hb9xcg/energex/supervisor/doc/supervisor.jpeg

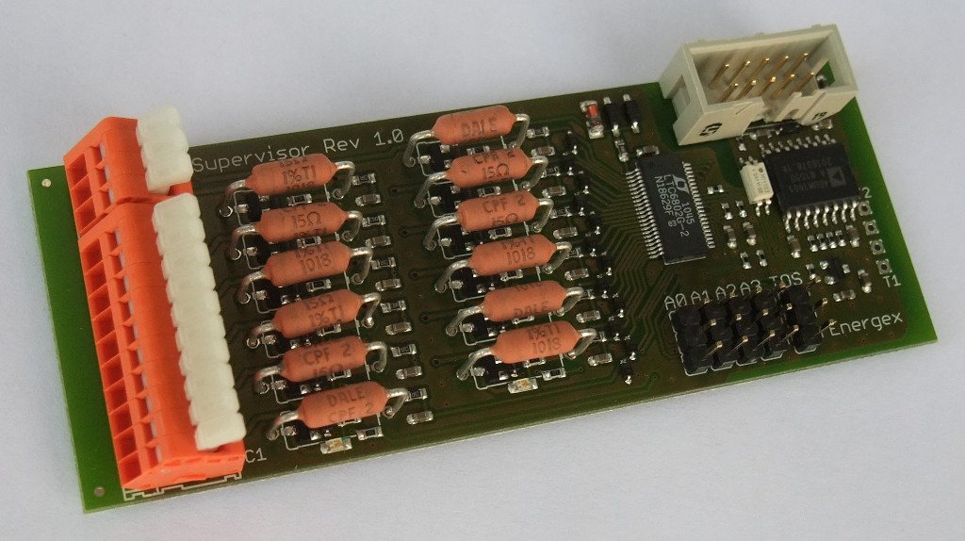
supervisor/doc/supervisor.jpeg
