hb9xcg/energex/QTwikeAnalyzer/README

QTwikeAnalyzer version 0.4

Thanx for downloading QTwikeAnalyzer

These are the features so far:
 * Recording and playback of the Twike RS485 traffic.
 * On the fly decoding of the protocol.
 * Creating voltage, current and temperature plots for each battery.
 * Downloading new firmware to mediator battery controller.

Please report bugs and tell me what you like/dislike
about the application!

Have a lot of fun
Markus Walser (markus.walser@gmail.com)
