hb9xcg/energex/mediator/doc/laden.odt

- Entladen
  - 287: BINFO ist 00 00
  - 287: D-State ist 6: Warten auf Netzspannung
  - 292: Relais-State (0x12) ist 11 (Relais Closed?)
  - 5071: FINFO ist 00 20
  - 5123: Sobald Batterie Spannung < 310V ist, wird BINFO 00 40: (zu tiefe Fahrspannung)
  - 24139: Sobald alle Batterien < 290V, wird entladen gestoppt.
- Warten auf Ladespannung
  - 24204: FINFO ist 00 20
- Vorladen
  - 24270: Wird mit D-State Broadcast zweimal angekündigt: (d-State = Vorladen)
  - 24497: FINFO ist 00 20
  - 24743: Relais State closed (0x11)
  - 24791: FINFO ist 00 20
  - 25084: FINFO ist 00 20
  - 25001: BINFO wechselt von 00 40 zu 00 00, da Batterie Spannung wieder > 310V
  - Ladestrom steigt mit zunehmender Batteriespannung auf 0.22A / Block (0.66A total)
- Vorlade Relais schliessen
  - 29992: Wir mit D-State Broadcast zweimal angekündigt: (d-State = 8)
  - 30001: BINFO ist 00 00
  - 30004: Relais-State Command 0x12 -> Relais schliessen (0x11)
  - 30015: BINFO ist 00 00
- I-Ladung
  - 30018: Wird mit D-State Broadcast zweimal angekündigt (d-State = 9)
  - 30475: BINFO ist 00 00
  - Ladestrom steigt auf total 4.5A
  - 31414: FINFO ist 00 20
  - 69726: Broadcast Relais State Command (0x12) -> Close (0x01), es sind 410V erreicht.
  - Ladestrom wird reduziert, Spannung fällt.
  - 69789: BINFO ist 00 00
  - 69869: Relais State ist closed (0x01)
  - 77581: FINFO ist 00 20
  - 78290: D-State ist immer noch 9 (I-Ladung)
- U-Ladung
  - 79673: Wird beim erreichen von 435V mit zwei Broadcasts angekündigt (d-State = 0xA)
  - 79685: BINFO ist 00 00
  - 80097: Relais State ist noch closed (0x01)
  - 81441: FINFO ist 00 20
  - 88114: BINFO ist 09 05 (Charge Temp To Low, Batt Full, Drive NOK, Rekup NOK) Gemäss Checksumme ist BINFO aber eher 01 03 (Batt Full, Rekup NOK, Charge NOK)
- Batterie Relais öffnen
  - 88115: Wird mit D-State Broadcast zweimal angekündigt (d-State = 0xB) während Batteriestrom noch ~1A / Block ist.
  - 88122: BINFO von Batterie 3 ist 0x01 0x01: (BatFull, Rekup NOK)
  - Strom wird auf 0A reduziert.
  - 88167: Message an Batterie 3: Open Relais
  - 88171: BINFO von Batterie 3 wird 0x01 0x81 (Bat Full, BatRelaisOpen, Rekup NOK)
- Nachladung
  - 88220: Wird mit zwei Broadcasts angekündigt (d-State = 0x0C)
  - 88231: Batterie 2 Relais State Closed (0x01)
  - 88233: Batterie 3 Relais State Open (0x00)
  - 88279: FINFO Bat 2 (und Bat 1) 00 20
  - 88281: FINFO Bat 3 00 64 (zusätzlich wurden Bit 2 und Bit 6 gesetzt)
  - Ladestrom wird erhöht.
  - 90271: Batterie 2 meldet BINFO 0x01 0x01
- Batterie Relais öffnen
  - 90274: .Wird mit D-State Broadcast zweimal angekündigt (d-State 0x0b) während Ladestrom noch je ~0.5A bei Block 1 und Block 2 ist.
  - Ladestrom wird auf 0A reduziert.
  - 90326: Message an Batterie 2: Open Relais
  - 90328: BINFO von Bat 2 ist neu 0x01 0x81 (BatFull, BatRelOpen, Rekup NOK)
- Nachladung
  - 90377: Wird mit zwei Broadcast angekündigt (d-State =0xC)
  - 90636: FINFO von Bat 2 ist neu wie von Bat 3 auch 0x00 0x64
  - 91390: Batterie 1 meldet BINFO 0x01 0x01 (BatFull, Rekup NOK)
- Batterie Relais öffnen
  - 91393: Wird mit D-State Broadcast zweimal angekündigt (d-State = 0xB) während Ladestrom von Batterie 1 noch 0.5A ist.
  - Ladestrom wird auf 0A reduziert.
  - 91440: BINFO sind Bat1 0x01 0x01, Bat2 0x01 0x81 und Bat3 0x01 0x81
- Batterie Relais schliessen
  - 91445: Wird mit zwei Broadcast angekündigt (d-State =0x0D)
  - 91520: FINFO von Bat1 0x00 0x24
  - 91522: FINFO von Bat2 0x00 0x64
  - 94567: Broadcast an alle Batterien das Relais (0x12) zu schliessen (0x01)
  - Alle Batterien melden BINFO 0x01 0x01
- Symetrierladung
  - 94577: Wird mit zwei Broadcasts angekündigt (d-State = 0x0E)
  - 94768: FINFO von Bat1 0x0024
  - 94760: FINFO von Bat2 0x0064
  - 94772: FINFO von Bat3 0x0064
  - Ladestrom wird erhöht.
  - 96352: Bei Bat3 steigt der Strom auf 0.29A, worauf diese BINFO 0x0109 meldet (BatFull, RekupNOK, ChargeCurrToHigh)
  - Der Ladestrom wird auf 0.28A reduziert
  - 96394: Bei Bat3 steigt der Strom auf 0.29A, worauf diese BINFO 0x0109 meldet (BatFull, RekupNOK, ChargeCurrToHigh)
  - Der Ladestrom wird auf 0.28A reduziert
  - 96522: FINFO von Bat1 0x0024
  - 96524: FINFO von Bat2 0x0064
  - 96526: FINFO von Bat3 0x0064
- Pause
  - 107329: Wird mit zwei Broadcasts angekündigt (d-State = 0x10) während Symmetrierstrom von noch je ~0.28A ist.
  - Symmetrierstrom wird auf 0A reduziert.
  - 107343: Broadcast an alle Batterien das Relais (0x12) zu öffnen (0x00)
  - Alle Batterien melden BINFO 0x0181
  - 107404: FINFO von Bat1 0x0024
  - 107406: FINFO von Bat2 0x0064
  - 107408: FINFO von Bat3 0x0064
