hb9xcg/energex/mediator/doc/boot-sequence.odt

Request Type, Checksum ok, Checksum bad, Current, Voltage, Values

10 31 42 27 65 Bat1: Ah Zähler?

10 31 48 80 ff fd 87 d8 36 a3 Bat1: 347.76V -0.02A 5.4Ah

10 32 42 27 65 ff fe 88 53 28 3a 349V

10 32 42 27 65 Bat2: Ah Zähler?

10 32 48 80 ff ff 88 57 28 3f Bat2: 349.03V 0.00A 4.0Ah

10 ff 24 11 01 34 Twike: ? Alle Relais öffnen?

10 ff 24 11 01 34 Twike: ? Alle Relais öffnen?

10 34 42 27 65 Bat3: Ah Zähler?

10 34 48 80 ff fd 88 3f 3b 46 Bat3: 348.79V -0.02A 5.9Ah

10 31 42 61 23 Bat1: Maximale Batterie Temperatur?

10 31 48 80 ff ff 87 db 04 b8 28 Bat1: 347.79V 0.00A 12.08°C

10 ff 24 11 03 36

10 ff 24 11 03 36

10 32 42 61 23 Bat2: Maximale Batterie Temperatur?

10 32 48 80 ff ff 88 5a 04 b8 a6 Bat2: 349.06V 0.00A 12.08°C

10 ff 24 11 30 Alle Relais öffnen! ???

10 ff 24 11 30 Alle Relais öffnen! ???

10 34 42 61 23 Bat3: Maximale Batterie Temperatur?

10 34 48 80 ff fd 88 44 04 ff fd Bat3: 348.84V -0.02A 12.79°C

10 31 42 74 36 Bat1: Entladene Ah?

10 31 48 80 ff ff 87 e1 03 f7 5a Bat1: 347.85V 0.00A 1015Ah

10 32 42 74 36 Bat2: Entladene Ah?

10 32 48 80 ff ff 88 5e 04 21 3b Bat2: 349.10V 0.00A 1057Ah

10 34 42 74 36 Bat3: Entladene Ah?

10 34 48 80 ff fd 88 4d 03 eb e7 Bat3: 349.10V -0.02A 1003Ah

10 31 42 02 40 Bat1: Program Revision?

10 31 48 80 ff ff 87 e0 02 12 bf Bat1: 347.84V 0.00A v5.30

10 32 42 02 40 Bat2: Program Revision?

10 32 48 80 ff ff 88 61 02 12 31 Bat2: 349.13V 0.00A v5.30

10 34 42 02 40 Bat3: Program Revision?

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

10 34 42 47

10 34 48 ff fe 88 56 04 dc 4f

10 31 42 27 65

10 31 48 88 06 36 f0

10 32 42 27 65

10 32 48 88 70 28 98

10 34 42 27 65

10 34 48 ff fe 88 60 3b 9a

10 31 42 31 73

10 31 48 88 1e d5

10 32 42 31 73

10 32 48 88 77 bc

10 34 42 31 73

10 34 48 ff fe 88 5e 2b b4
