hb9xcg/energex/mediator/doc/twike-ebnf.odt

Transfer

Transfer --> Unacked oder Acked

Unacked --> Message

Message --> Header und Command und Checksum

Acked --> Request und Response

Header --> Start und Address und Type

Request --> Header und Parameter und Checksum

Start --> 0x10

Address --> Batterie1 oder Batterie2 oder Batterie3 oder Broadcast

Batterie1 --> 0x31

Batterie2 --> 0x32

Batterie3 --> 0x34

Broadcast --> 0xff

Type --> RequestType oder ResponseType oder MessageType

RequestType --> 0x42

ResponseType --> 0x48

MessageType --> 0x24

Response --> Header und Data und Checksum

Data --> QCounter oder MaxBatT oder ProgRev oder dState oder LadeI oder FahrI oder

SollLadeU oder Leistung oder BatT oder FINFO oder SymU oder TeilU oder Temp oder

UmgT oder MaxQ oder EntQ oder SymI

Qcounter --> Strom und Spannung und Kapazität

MaxBatT --> Strom und Spannung und

ProgRev --> Strom und Spannung und Revision

LadeI -->

FahrI -->

10 32 42 27 65 10 32 48 80 ff ff 88 57 28 3f
