hb9xcg/energex/supervisor/eagle/partlist.pdf

Tabelle1_2

Part | | | Linear | SMD
C1 | 100n / 100V | C0603 | 81-GCM188R72A104KA4D | x
C2 | 100n / 100V | C0603 | 81-GCM188R72A104KA4D | x
C3 | 100n / 100V | C0603 | 81-GCM188R72A104KA4D | x
C4 | 100n / 100V | C0603 | 81-GCM188R72A104KA4D | x
C5 | 100n / 100V | C0603 | 81-GCM188R72A104KA4D | x
C6 | 100n / 100V | C0603 | 81-GCM188R72A104KA4D | x
C7 | 100n / 100V | C0603 | 81-GCM188R72A104KA4D | x
C8 | 100n / 100V | C0603 | 81-GCM188R72A104KA4D | x
C9 | 100n / 100V | C0603 | 81-GCM188R72A104KA4D | x
C10 | 100n / 100V | C0603 | 81-GCM188R72A104KA4D | x
C11 | 100n / 100V | C0603 | 81-GCM188R72A104KA4D | x
C12 | 100n / 100V | C0603 | 81-GCM188R72A104KA4D | x
C13 | 100n / 100V | C0603 | 81-GCM188R72A104KA4D | x
C14 | 1u / 16V | C0603 | 810-C1608Y5V1E105Z | x
C15 | 1u / 16V | C0603 | 810-C1608Y5V1E105Z | x
C16 | 1u / 16V | C0603 | 810-C1608Y5V1E105Z | x
C17 | 1u / 16V | C0603 | 810-C1608Y5V1E105Z | x
C18 | 100n | C0603 | 81-GCM188R72A104KA4D | x
C19 | 100n | C0603 | 81-GCM188R72A104KA4D | x
C20 | 100n | C0603 | 81-GCM188R72A104KA4D | x
C21 | 100n | C0603 | 81-GCM188R72A104KA4D | x
C22 | 1u / 16V | C0603 | 810-C1608Y5V1E105Z | x
CON1 | SPI | CON10 | 617- 09- 18- 510- 7324
D1 | MM3Z12VT1G | SOD323-R | 863-MM3Z12VT1G | x
D2 | PDZ6.2B | SOD323-R | 771-PDZ6.2BT/R | x
D3 | MM3Z12VT1G | SOD323-R | 863-MM3Z12VT1G | x
D4 | PDZ6.2B | SOD323-R | 771-PDZ6.2BT/R | x
D5 | MM3Z12VT1G | SOD323-R | 863-MM3Z12VT1G | x
D6 | PDZ6.2B | SOD323-R | 771-PDZ6.2BT/R | x
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
R51 | 20 | R0603 | 652-CR0603JW-200ELF | x
R52 | 100k | R0402 | P100KDETR-ND | x
R53 | 100k | R0402 | P100KDETR-ND | x
R54 | 100k | R0402 | P100KDETR-ND | x
R55 | 100k | R0402 | P100KDETR-ND | x
R57 | 1M | R0402 | 652-CR0402-JW-105GLF | x
R58 | 1M | R0402 | 652-CR0402-JW-105GLF | x
R59 | 1M | R0402 | 652-CR0402-JW-105GLF | x
R60 | 100k | R0402 | P100KDETR-ND | x
R61 | 100k | R0402 | P100KDETR-ND | x
T1 | BSS308PE | SOT23 | 726- BSS308PEL6327 | x
T1A | WIREPAD1,6/0,8 | 1,6/0,8
T1B | WIREPAD1,6/0,8 | 1,6/0,8
T2 | BSS308PE | SOT23 | 726- BSS308PEL6327 | x
T2A | WIREPAD1,6/0,8 | 1,6/0,8
T2B | WIREPAD1,6/0,8 | 1,6/0,8
T3 | BSS308PE | SOT23 | 726- BSS308PEL6327 | x
T4 | BSS308PE | SOT23 | 726- BSS308PEL6327 | x
T5 | BSS308PE | SOT23 | 726- BSS308PEL6327 | x
T6 | BSS308PE | SOT23 | 726- BSS308PEL6327 | x
T7 | BSS308PE | SOT23 | 726- BSS308PEL6327 | x
T8 | BSS308PE | SOT23 | 726- BSS308PEL6327 | x
T9 | BSS308PE | SOT23 | 726- BSS308PEL6327 | x
T10 | BSS308PE | SOT23 | 726- BSS308PEL6327 | x
T11 | BSS308PE | SOT23 | 726- BSS308PEL6327 | x
T12 | BSS308PE | SOT23 | 726- BSS308PEL6327 | x
T13 | PMV30UN | SOT23 | 771-PMV30UN-T/R | x
X2 | 11..12 | 233-503 | 141703
X3 | 1..10 | 233-510 | 141701
