hb9xcg/energex/daisy/doc/bom.ods

Sheet: Tabelle1
Bauteil | Farnel | Anzahl | Preis 1Stück | Preis 100Stück | Preis 1000Stück | Total
Attiny26L | 9171665 | 100 | 4.7 | 2.35 |  | 235
ADUM1251 | 1439002 | 100 | 13.9 | 7.95 |  | 795
LP3985IM5-3.0 | 1469153 | 100 | 0.73 | 0.47 |  | 46.9
10uH ELJFA100JF | 1198456 (http://ch.farnell.com/1198456/passive-bauelemente/product.us0?sku=panasonic-eljfa100jf) | 100 | 0.84 | 0.58 |  | 58.1
LM61BIM3 | 1197387 | 100 | 2.55 | 1.75 |  | 175
1uF/6.3V | 9527699 | 200 | 0.07 | 0.05 |  | 10.2
TYCO 8Pin Bus | 148751 | 100 | 1.55 | 1.55 |  | 155
TLP281 | 1225848 | 200 | 1.15 | 0.8 |  | 160
10nF | 9695028 | 100 | 0.78 | 0.64 |  | 64.3
150R 2% 0.25W | 1100169 | 1000 | 0.09 | 0.07 | 0.05 | 50
680R | 9337547 | 100 | 0.07 | 0.07 |  | 6.5
100k 5% | 9234250 | 500 | 0.11 | 0.11 | 0.08 | 56.5
FDN337N | 9845356 (http://ch.farnell.com/jsp/search/productdetail.jsp?sku=9845356) | 100 | 0.79 | 0.48 | 0.34 | 48
FUSE 2.5A SMD | 9922377 (http://ch.farnell.com/jsp/search/productdetail.jsp?sku=9922377) | 100 | 1.2 | 1.1 | 0.82 | 110
BZV55-C5V6 | 1097203 (http://ch.farnell.com/jsp/search/productdetail.jsp?sku=1097203) | 100 | 0.23 | 0.17 | 0.14 | 16.7
100k 0.1% | 1160261 (http://ch.farnell.com/jsp/search/productdetail.jsp?sku=1160261) | 100 | 1.5 | 0.86 |  | 86.3
76k8 0.1% | 1353303 (http://ch.farnell.com/1353303/passive-bauelemente/product.us0?sku=welwyn-pcf0805r-76k8bt1) | 100 | 1.2 | 0.69 |  | 68.8
100nF / 25V | 317287 (http://ch.farnell.com/jsp/search/productdetail.jsp?sku=317287) | 500 | 0.11 | 0.1 | 0.04 | 49
180R / 5% | 9233911 (http://ch.farnell.com/jsp/search/productdetail.jsp?sku=9233911) | 400 | 0.06 | 0.06 | 0.04 | 22.4
Bauteile total |  |  |  |  |  | 2213.7
16mm x 100mm |  | 100 | 24.15 |  |  | 2415
Alles |  |  |  |  |  | 4628.7
Maschinelle Fertigung:
Material |  | 17dm2 |  |  |  | 834
Siebdruck |  |  |  |  |  | 350
Programm |  |  |  |  |  | 300
Init PCB |  |  |  |  |  | 950
Einrichtungskosten / Los |  |  |  |  |  | 180
Total |  |  |  |  |  | 2614

Sheet: Tabelle2
Bauteil | Farnel | Anzahl | Preis 1Stück | Preis 100Stück | Preis 1000Stück | Total
ATMega48 | 9171312 (http://ch.farnell.com/9171312/ics-quarze/product.us0?sku=atmel-atmega48-20au) | 100 | 5.15 | 2.55 |  | 255
ADM3488 | 1274166 (http://ch.farnell.com/jsp/search/productdetail.jsp?sku=1274166) | 100 | 4.6 | 2.35 |  | 235
LP3985IM5-3.0 | 1469153 | 100 | 0.73 | 0.47 |  | 46.9
10uH ELJFA100JF | 1198456 (http://ch.farnell.com/1198456/passive-bauelemente/product.us0?sku=panasonic-eljfa100jf) | 100 | 0.84 | 0.58 |  | 58.1
1uF/6.3V | 9527699 | 300 | 0.07 | 0.05 |  | 15.3
ADR361AUJZ | 1117861 (http://ch.farnell.com/jsp/search/productdetail.jsp?sku=1117861) | 100 | 2.65 | 2.05 |  | 205
10nF | 9695028 | 100 | 0.78 | 0.64 |  | 64.3
150R 2% 0.25W | 1100169 | 2000 | 0.09 | 0.07 | 0.05 | 100
100k 5% | 9234250 | 100 | 0.11 | 0.11 | 0.08 | 11.3
FDN337N | 9845356 (http://ch.farnell.com/jsp/search/productdetail.jsp?sku=9845356) | 100 | 0.79 | 0.48 | 0.34 | 48
100k 0.1% | 1160261 (http://ch.farnell.com/jsp/search/productdetail.jsp?sku=1160261) | 100 | 1.5 | 0.86 |  | 86.3
76k8 0.1% | 1353303 (http://ch.farnell.com/1353303/passive-bauelemente/product.us0?sku=welwyn-pcf0805r-76k8bt1) | 100 | 1.2 | 0.69 |  | 68.8
100nF / 25V | 317287 (http://ch.farnell.com/jsp/search/productdetail.jsp?sku=317287) | 600 | 0.11 | 0.1 | 0.04 | 58.8
180R / 5% | 9233911 (http://ch.farnell.com/jsp/search/productdetail.jsp?sku=9233911) | 200 | 0.06 | 0.06 | 0.04 | 11.2
Bauteile total |  |  |  |  |  | 1264
16mm x 100mm |  | 100 | 24.15 |  |  | 2415
Print und Bauteile |  |  |  |  |  | 3679
Maschinelle Fertigung:
Material |  | 17dm2 |  |  |  | 834
Siebdruck |  |  |  |  |  | 350
Programm |  |  |  |  |  | 300
Init PCB |  |  |  |  |  | 950
Einrichtungskosten / Los |  |  |  |  |  | 180
Total |  |  |  |  |  | 2614
