hb9xcg/energex/plc/doc/trafo.pdf

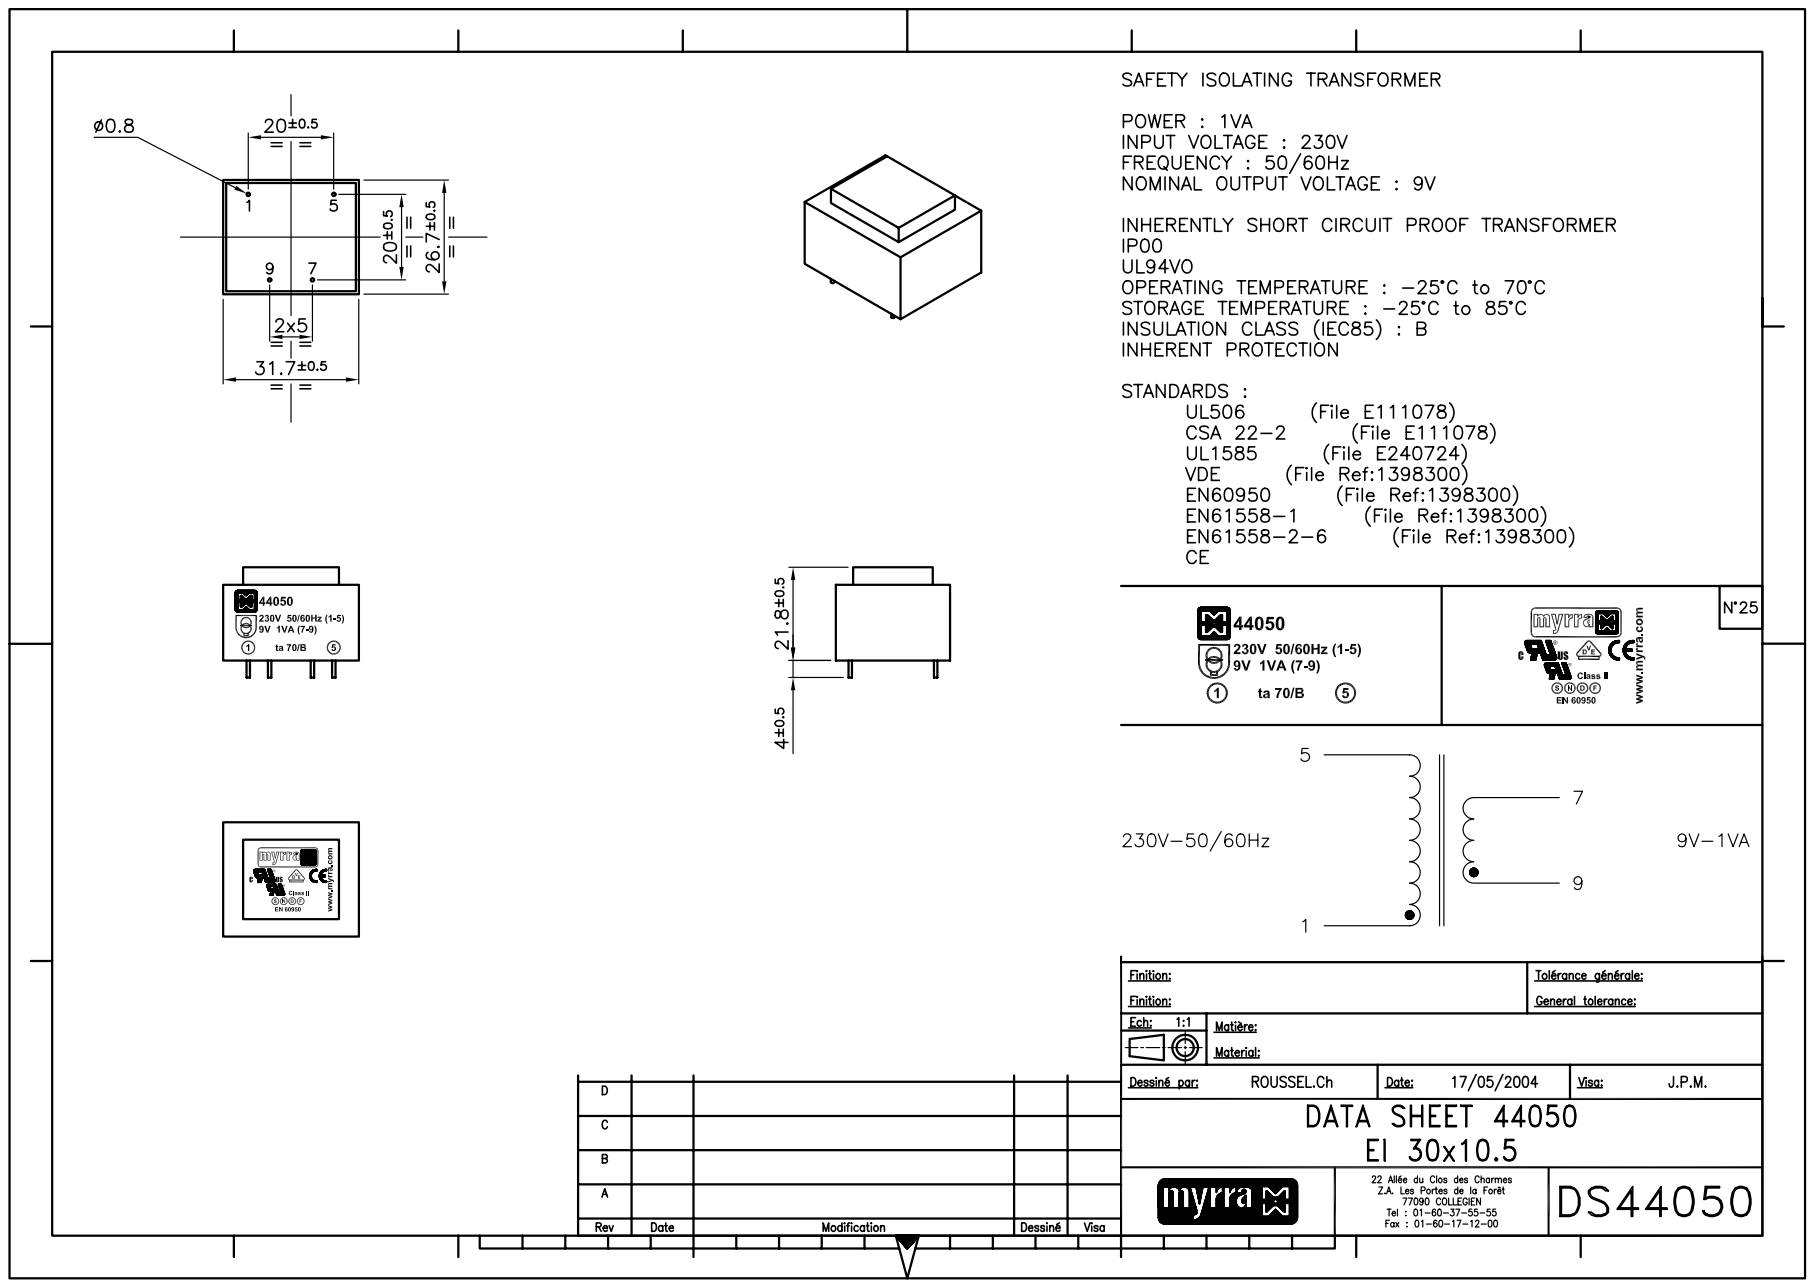
[picture p2: page 1]
