hb9xcg/energex/mediator/eagle/mediator.brd

## EAGLE design mediator/eagle/mediator.brd (2013-05-06)

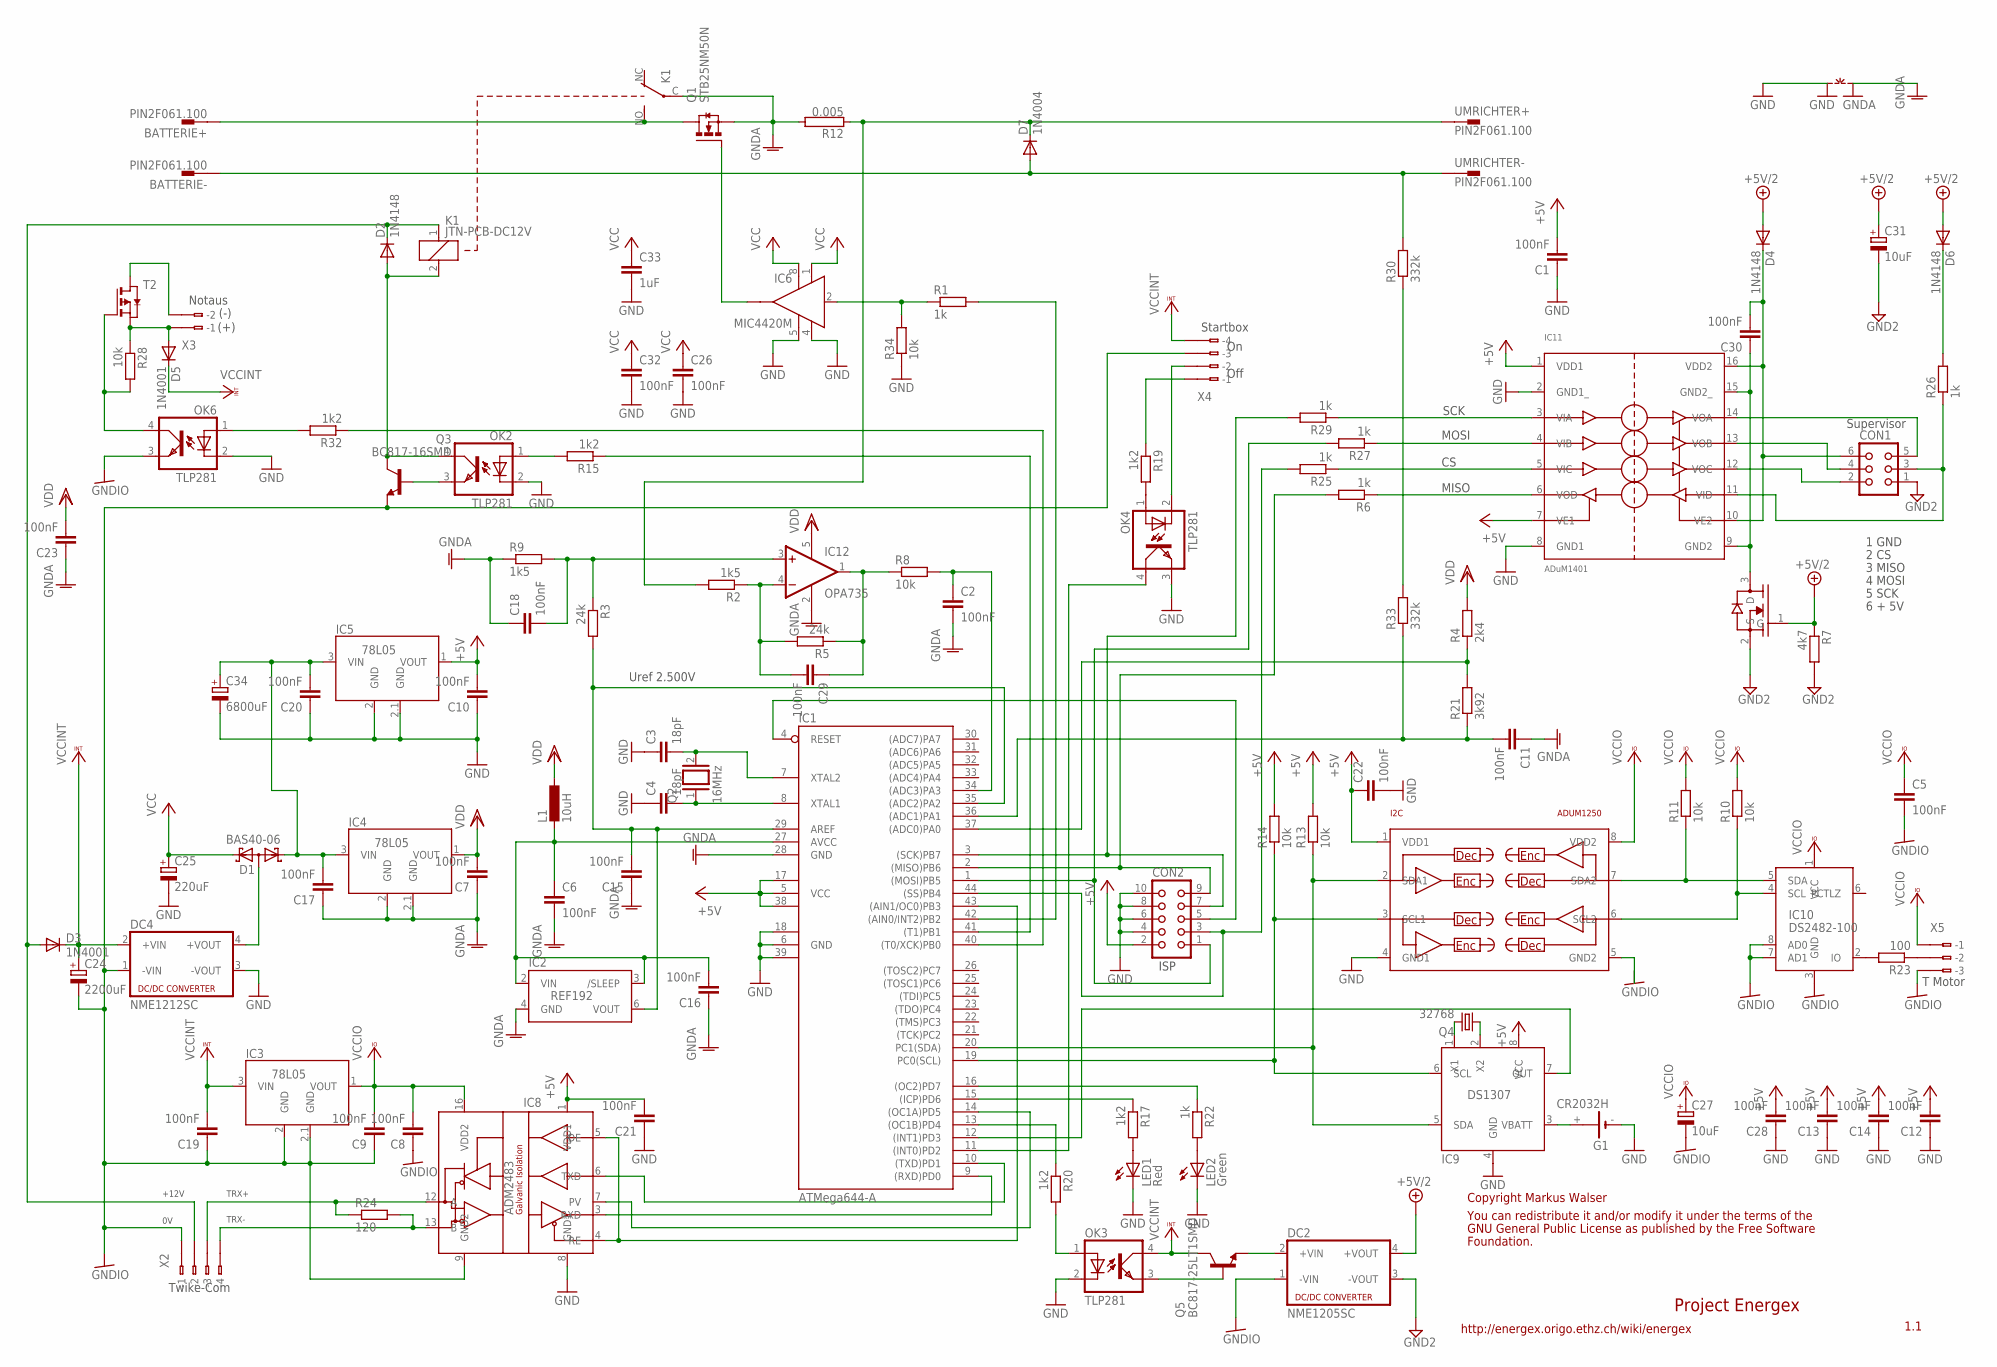
[picture p3: schematic mediator.sch]

Parts:
BATTERIE+: PIN2F061.100; F061.100
BATTERIE-: PIN2F061.100; F061.100
C1, C2, C5, C6, C7, C8, C9, C10, C11, C12, C13, C14, C15, C16, C17, C18, C19, C20, C21, C22, C23, C26, C28, C29, C30, C32: 100nF; C0603K
C3, C4: 18pF; C0603K
C24: 2200uF; E5-10,5
C25: 220uF; E2,5-6
C27, C31: 10uF; SMC_A
C33: 1uF; C0603K
C34: 6800uF; E7,5-16
CON1: CON06
CON2: CON10
D1: BAS40-06; SOT23
D2, D4, D6: 1N4148; MICROMELF-R
D3, D5: 1N4001; DO214AC
D7: 1N4004; DO41-10
DC2: NME1205SC; NME
DC4: NME1212SC; NME
G1: CR2032H
I2C: ADUM1250; SO8
IC1: ATMega644-A; TQFP44
IC2: REF192; SO08
IC3, IC4, IC5: 78L05; SOT89
IC6: MIC4420M; SO-08
IC8: ADM2483; SO16W
IC9: DS1307; SO08
IC10: DS2482-100; SO08
IC11: ADuM1401; SO16W
IC12: OPA735; SOT23-5
K1: JTN-PCB-DC12V; JT-PCB
L1: 10uH; L3225M
LED1: Red; CHIPLED_0805
LED2: Green; CHIPLED_0805
OK2, OK3, OK4, OK6: TLP281; MINI-FLAT-4
Q1: STB25NM50N; D2PACK
Q2: 16MHz; QS
Q3: BC817-16SMD; SOT23-BEC
Q4: 32768; TC26H
Q5: BC817-25LT1SMD; SOT23-BEC
R1, R22, R26: 1k; R0603
R2, R9: 1k5; M0805
R3, R5: 24k; M0805
R4: 2k4; M0805
R6, R25, R27, R29: 1k; M0805
R7: 4k7; R0603
R8, R10, R11, R13, R14, R28: 10k; M0805
R12: 0.005; KH208-8
R15, R17, R19, R20, R32: 1k2; R0603
R21: 3k92; M0805
R23: 100; M0805
R24: 120; R0603
R30: 332k; 0207/10
R33: 332k; 0207/5V
R34: 10k; R0603
T1: FDN337N; SOT23
T2: PMOSSOT23; SOT-23
UMRICHTER+: PIN2F061.100; F061.100
UMRICHTER-: PIN2F061.100; F061.100
X2, X4: 233-104
X3: 233-102
X5: 233-203
~NUDEV~1: GND-GNDA

Connections:
+5V: C1.2, C10.2, C12.2, C13.2, C14.2, C21.2, C22.1, C28.2, CON2.2, I2C.1 (VDD1), IC1.5 (VCC), IC1.17 (VCC1), IC1.38 (VCC2), IC5.1 (VOUT), IC8.1 (VDD1), IC9.8 (VCC), IC11.1 (VDD1), IC11.7 (VE1), R13.2, R14.2
+5V/2: C31.+, D4.A, D6.A, DC2.4 (+VOUT), R7.1, T1.1 (G)
GND: C1.1, C3.1, C4.1, C10.1, C12.1, C13.1, C14.1, C20.1, C21.1, C22.2, C25.-, C26.2, C28.1, C32.2, C33.2, C34.-, CON2.4, CON2.6, CON2.8, CON2.10, DC4.3 (-VOUT), G1.-, I2C.4 (GND1), IC1.6 (GND), IC1.18 (GND1), IC1.39 (GND2), IC5.2 (GND), IC5.2.1 (GND), IC6.4 (GND), IC6.5 (GND1), IC8.8 (GND1), IC9.4 (GND), IC11.2 (GND1_), IC11.8 (GND1), LED1.C, LED2.C, OK2.2 (C), OK3.2 (C), OK4.3 (EMIT), OK6.2 (C), R34.1, ~NUDEV~1.GND
GND2: C31.-, CON1.1, DC2.3 (-VOUT), R7.2, T1.2 (S)
GNDA: C2.2, C6.2, C7.1, C11.1, C15.1, C16.1, C17.1, C18.1, C23.1, IC1.28 (GND), IC2.4 (GND), IC4.2 (GND), IC4.2.1 (GND), IC12.2 (V-), K1.C, Q1.3 (S), R9.1, R12.2, ~NUDEV~1.GNDA
GNDIO: C5.2, C8.1, C9.1, C19.1, C24.-, C27.-, DC2.1 (-VIN), DC4.1 (-VIN), I2C.5 (GND2), IC3.2 (GND), IC3.2.1 (GND), IC8.9 (GND2), IC10.3 (GND), IC10.7 (AD1), IC10.8 (AD0), OK6.3 (EMIT), Q3.E, X2.B1 (B-1), X4.B3 (B-3), X5.B3 (B-3)
unnamed: IC6.6 (OUT), Q1.1 (G)
unnamed: BATTERIE+.A1 (1), K1.NO (S), Q1.2 (D)
unnamed: IC9.1 (X1), Q4.2
unnamed: CON2.7, IC1.3 ((SCK)PB7), R29.2
unnamed: C18.2, IC12.3 (+IN), R3.1, R9.2
unnamed: C29.2, IC12.4 (-IN), R2.1, R5.2
unnamed: C29.1, IC12.1 (OUT), R5.1, R8.1
unnamed: CON2.1, IC1.1 ((MOSI)PB5), R27.2
unnamed: DC2.2 (+VIN), Q5.E
unnamed: CON2.3, IC1.44 ((SS)PB4), R25.2
unnamed: C2.1, IC1.34 ((ADC3)PA3), R8.2
unnamed: C3.2, IC1.7 (XTAL2), Q2.2
unnamed: C4.2, IC1.8 (XTAL1), Q2.1
unnamed: I2C.6 (SCL2), IC10.4 (SCL), R10.1
unnamed: I2C.7 (SDA2), IC10.5 (SDA), R11.1
unnamed: D7.C, R2.2, R12.1, UMRICHTER+.A1 (1)
unnamed: IC10.2 (IO), R23.2
unnamed: BATTERIE-.A1 (1), D7.A, R30.2, UMRICHTER-.A1 (1)
unnamed: IC1.37 ((ADC0)PA0), R4.1, R21.2
unnamed: OK2.3 (EMIT), Q3.B
unnamed: OK2.1 (A), R15.2
unnamed: C6.1, C16.2, IC1.27 (AVCC), IC2.2 (VIN), IC2.3 (/SLEEP), L1.2
unnamed: I2C.2 (SDA1), IC1.20 (PC1(SDA)), IC9.5 (SDA), R13.1
unnamed: I2C.3 (SCL1), IC1.19 (PC0(SCL)), IC9.6 (SCL), R14.1
unnamed: IC1.41 ((T1)PB1), R15.1
unnamed: D2.C, D3.A, K1.1, X2.B2 (B-2)
unnamed: IC1.15 ((ICP)PD6), R17.1
unnamed: D2.A, K1.2, OK2.4 (COL), Q3.C
unnamed: IC1.9 ((RXD)PD0), IC8.3 (RXD)
unnamed: CON2.9, IC1.2 ((MISO)PB6), R6.2
unnamed: IC1.42 ((AIN0/INT2)PB2), R1.2
unnamed: IC11.6 (VOD), R6.1
unnamed: D5.A, R28.1, T2.2 (S), X3.B1 (B-1)
unnamed: IC1.10 ((TXD)PD1), IC8.6 (TXD)
unnamed: CON1.2, IC11.12 (VOC)
unnamed: IC8.13 (B), R24.2, X2.B4 (B-4)
unnamed: IC1.16 ((OC2)PD7), R22.1
unnamed: IC8.12 (A), R24.1, X2.B3 (B-3)
unnamed: IC1.43 ((AIN1/OC0)PB3), IC8.4 (RE), IC8.5 (DE)
unnamed: IC1.14 ((OC1A)PD5), IC8.7 (PV)
unnamed: R23.1, X5.B2 (B-2)
unnamed: R30.1, R33.2
unnamed: T2.1 (D), X3.B2 (B-2)
unnamed: C30.1, IC11.9 (GND2), IC11.15 (GND2_), T1.3 (D)
unnamed: OK3.3 (EMIT), Q5.B
unnamed: OK3.1 (A), R20.2
unnamed: IC1.13 ((OC1B)PD4), R20.1
unnamed: IC1.11 ((INT0)PD2), OK4.4 (COL)
unnamed: OK4.2 (C), X4.B2 (B-2)
unnamed: OK4.1 (A), R19.2
unnamed: G1.+, IC9.3 (VBATT)
unnamed: CON1.3, IC11.11 (VID), R26.1
unnamed: CON1.4, IC11.13 (VOB)
unnamed: CON2.5, IC1.4 (RESET)
unnamed: CON1.5, IC11.14 (VOA)
unnamed: LED1.A, R17.2
unnamed: R19.1, X4.B1 (B-1)
unnamed: C15.2, IC1.29 (AREF), IC1.35 ((ADC2)PA2), IC2.6 (VOUT), R3.2
unnamed: IC1.12 ((INT1)PD3), IC9.7 (OUT)
unnamed: C30.2, CON1.6, D4.C, IC11.10 (VE2), IC11.16 (VDD2)
unnamed: C17.2, C20.2, C34.+, D1.1 (K1), IC4.3 (VIN), IC5.3 (VIN)
unnamed: IC9.2 (X2), Q4.1
unnamed: LED2.A, R22.2
unnamed: IC6.2 (IN), R1.1, R34.2
unnamed: D1.3 (AA), DC4.4 (+VOUT)
unnamed: C11.2, IC1.36 ((ADC1)PA1), R21.1, R33.1
unnamed: D6.C, R26.2
unnamed: IC11.5 (VIC), R25.1
unnamed: IC11.4 (VIB), R27.1
unnamed: IC11.3 (VIA), R29.1
unnamed: OK6.4 (COL), R28.2, T2.3 (G)
unnamed: OK6.1 (A), R32.2
unnamed: IC1.40 ((T0/XCK)PB0), R32.1
VCC: C25.+, C26.1, C32.1, C33.1, D1.2 (K2), IC6.1 (VS), IC6.8 (VS1)
VCCINT: C19.2, C24.+, D3.C, D5.C, DC4.2 (+VIN), IC3.3 (VIN), OK3.4 (COL), Q5.C, X4.B4 (B-4)
VCCIO: C5.1, C8.2, C9.2, C27.+, I2C.8 (VDD2), IC3.1 (VOUT), IC8.16 (VDD2), IC10.1 (VCC), R10.2, R11.2, X5.B1 (B-1)
VDD: C7.2, C23.2, IC4.1 (VOUT), IC12.5 (V+), L1.1, R4.2

Notes on the sheet:
Copyright Markus Walser
1.1
You can redistribute it and/or modify it under the terms of the
GNU General Public License as published by the Free Software
Foundation.
MISO
MOSI
SCK
Supervisor
Twike-Com
Startbox
Notaus
T Motor
ISP
Off
Uref 2.500V
Project Energex
http://energex.origo.ethz.ch/wiki/energex
+12V
TRX+
TRX-
(+)
(-)
3 MISO
2 CS
1 GND
4 MOSI
5 SCK
6 + 5V

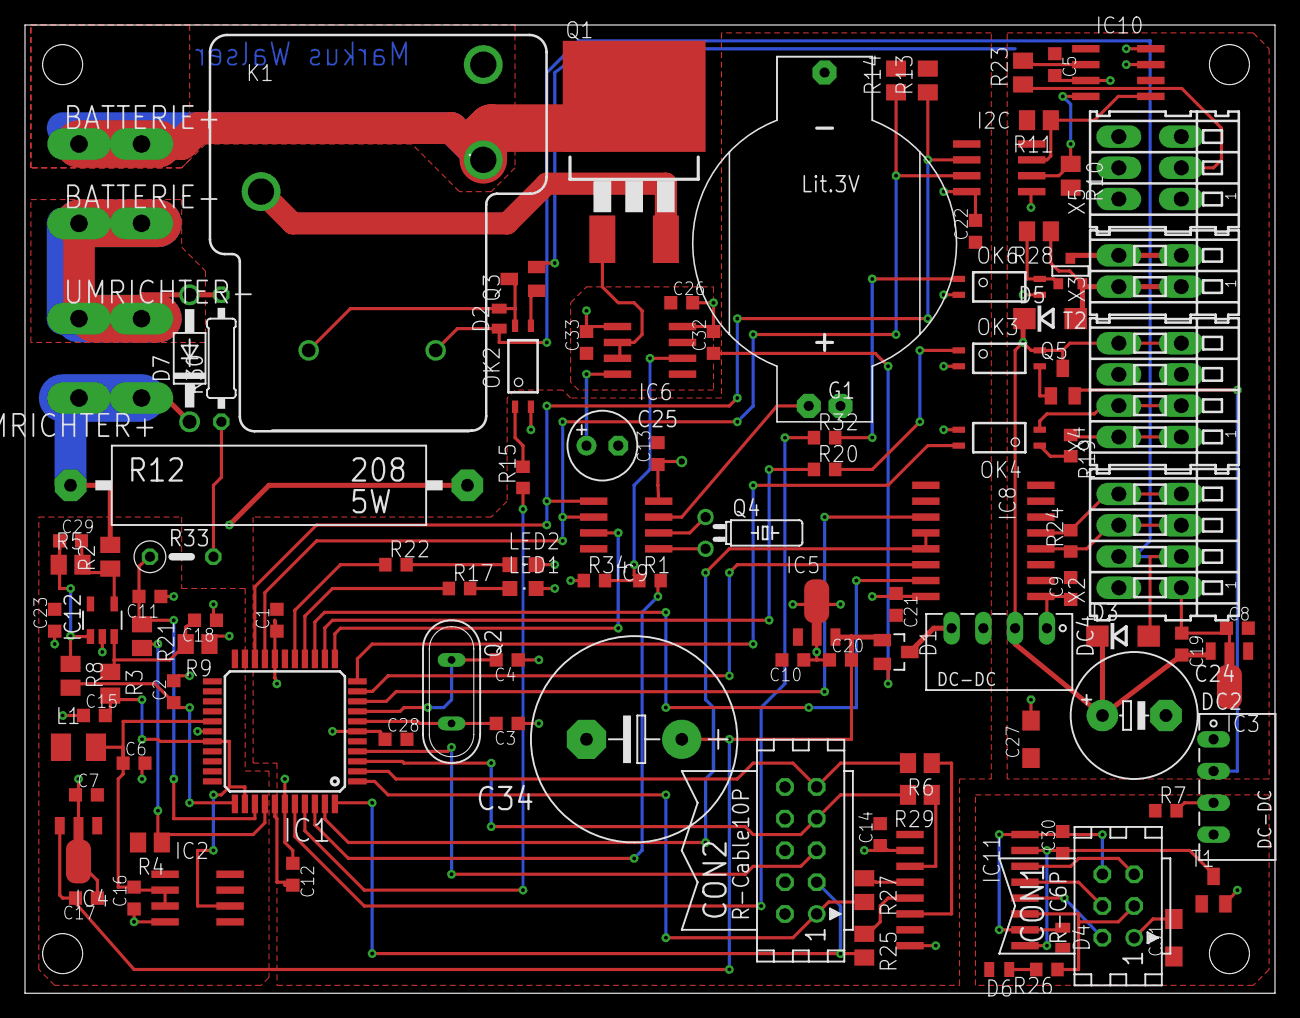
[picture p4: board mediator.brd from above]

Board: 2 copper layers, 100.0 x 77.5 mm, 113 parts (1 on the bottom side), 83 nets.
