hb9xcg/energex/mediator/atmel/io.c

/*
 * Energex
 * 
 * Copyright (C) 2008-2011 by Markus Walser
 * markus.walser@gmail.com
 *
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
 */

/*! 
 * @file 	io.c
 * @brief 	board specific io port configuration.
 * @author 	Markus Walser (markus.walser@gmail.com)
 * @date 	16.11.2010
 */
#include <avr/io.h>
#include <avr/interrupt.h>
#include "io.h"
#include "data.h"

//#define SMOKED_IGBT_PORT   // ATMega IGBT port is defect.

#define RELAIS		PB1
#ifndef SMOKED_IGBT_PORT
  #define IGBT		PB2
#else
  #define IGBT		PC3
#endif
#define LED_RED 	PD7
#define LED_GREEN	PD6
#define IO_POWER	PD4
#define STOP_SWITCH	PD2
#define EMERGENCY       PB0

static uint8_t io_stop;


void io_init(void)
{
        PORTA=0; DDRA=0;                        // Alles Eingang alles Null
        PORTB=0; DDRB=0;
        PORTC=0; DDRC=0;
        PORTD=0; DDRD=0;


        // Disable JTag to allow normal usage of Port C.
	MCUCR = 1<< JTD;
	MCUCR = 1<< JTD;


	DDRB |= (uint8_t)(1<<RELAIS);           // Relais output
#ifndef SMOKED_IGBT_PORT
	DDRB |= (uint8_t)(1<<IGBT);             // IGBT output
#else
	DDRC |= (uint8_t)(1<<IGBT);             // IGBT output
#endif
	
	DDRB |= (uint8_t)(1<<EMERGENCY);        // Emergency Output
	
	DDRD |= (uint8_t)(1<<LED_GREEN);        // Green LED output
	DDRD |= (uint8_t)(1<<LED_RED);          // Red LED output

	DDRD |= (uint8_t)(1<<IO_POWER);         // Interface power output

	DDRD  &= (uint8_t)~(1<<STOP_SWITCH);    // Input
	PORTD |= (uint8_t) (1<<STOP_SWITCH);    // Pullup enabled


	io_clear_green_led();
	io_clear_red_led();
	io_open_relais();
	io_disable_igbt();
	io_disable_interface_power();

	io_stop = io_get_stop();
}

void io_raise_emergency(void)
{
        PORTB &= (uint8_t)~(1<<EMERGENCY);  // Remove Twike control power
}

void io_release_emergency(void)
{
        PORTB |= (uint8_t)(1<<EMERGENCY);  // Remove Twike control power
}

void io_enable_interface_power(void)
{
	PORTD |= (uint8_t)(1<<IO_POWER);
}

void io_disable_interface_power(void)
{
	PORTD &= (uint8_t)~(1<<IO_POWER);
}

void io_enable_igbt(void)
{
#ifndef SMOKED_IGBT_PORT
	PORTB |= (uint8_t)(1<<IGBT);
#else
	PORTC |= (uint8_t)(1<<IGBT);
#endif
}

void io_disable_igbt(void)
{
#ifndef SMOKED_IGBT_PORT
	PORTB &= (uint8_t)~(1<<IGBT);
#else
	PORTC &= (uint8_t)~(1<<IGBT);
#endif
}

void io_close_relais(void)
{
	PORTB |= (uint8_t)(1<<RELAIS);
}

void io_open_relais(void)
{
	PORTB &= (uint8_t)~(1<<RELAIS);
}

uint8_t io_is_relais_closed(void)
{
	return (PORTB & (uint8_t)(1<<RELAIS));
}

void io_set_green_led(void)
{
	PORTD |= (uint8_t)(1<<LED_GREEN);
}

void io_clear_green_led(void)
{
	PORTD &= (uint8_t)~(1<<LED_GREEN);
}

void io_toggle_green_led(void)
{
	PORTD ^= (uint8_t)(1<<LED_GREEN);
}

void io_set_red_led(void)
{
	PORTD |= (uint8_t)(1<<LED_RED);
}

void io_clear_red_led(void)
{
	PORTD &= (uint8_t)~(1<<LED_RED);
}

void io_toggle_red_led(void)
{
	PORTD ^= (uint8_t)(1<<LED_RED);
}

uint8_t io_get_stop(void)
{
	return (PIND & (uint8_t)(1<<STOP_SWITCH));
}

void io_enable_stop_interrupt(void)
{
        EICRA = (1<<ISC01) | (1<<ISC10); // Configure any change on pin INT0 for interrupt.
        EIMSK = (1<<INT0);               // Enable INT0 interrupt
}

/*!
 *  * Interrupt-Handler fuer den Interrupt 0. Trennt den das ganze Twike von der Batterie.
 *   */
ISR (INT0_vect)
{

	if (mediator_get_drive_state() == eConverterOff)
	{
		io_release_emergency();
	}
	else
	{
		io_raise_emergency();

		io_set_red_led();
		data_save();
		io_clear_red_led();

		ePowerSoll = ePowerSave;
		io_disable_interface_power();
		
		mediator_set_drive_state(eConverterOff);
	}
}
