hb9xcg/energex/mediator/atmel/i2c.c

/*
 * Energex
 * 
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
 */

/*! 
 * @file 	i2c.c
 * @brief 	I2C-Treiber, derzeit nur Master, interruptbasiert
 * @author 	Timo Sandmann (mail@timosandmann.de)
 * @date 	05.09.2007
 */

#include "mediator.h"

#ifdef I2C_AVAILABLE
#include <util/twi.h>
#include <avr/interrupt.h>
#include <stdlib.h>
#include "timer.h"

#define I2C_PRESCALER 0				/*!< Prescaler fuer I2C-CLK */

static uint8_t sl_addr = 0;			/*!< Adresse des Slaves */
static const uint8_t * pTxData = NULL;	/*!< Zeiger auf Puffer fuer Datenversand */
static uint8_t * pRxData = NULL;	/*!< Zeiger auf Puffer fuer Datenempfang */
static uint8_t txSize = 0;			/*!< Anzahl der zu sendenden Datenbytes */
static uint8_t rxSize = 0;			/*!< Anzahl der zu lesenden Datenbytes */
static uint8_t i2c_error = 0;		/*!< letzter Bus-Fehler */
static volatile uint8_t i2c_complete = 0;	/*!< Spin-Lock; 0: ready, 128: Transfer aktiv */


#ifdef DEBUG
static char i2c_debug[64];
#define TRACE(x)        sprintf((char*)i2c_debug, "%s:%d time=%d\r\n", __FUNCTION__, __LINE__, x); \
                        uart_write(i2c_debug, strlen((char*)i2c_debug));
#else
#define TRACE(x)
#endif

/*!
 * ISR fuer I2C-Master
 */
ISR(TWI_vect) {
	uint8_t state = TWSR;
#if I2C_PRESCALER != 0
	state &= 0xf8; 
#endif
	switch (state) {
		/* Start gesendet */
		case TW_START:
			/* no break */
		case TW_REP_START: {
			if (txSize > 0) {
				/* Adresse+W senden */
				TWDR = sl_addr & 0xfe;	// W
			} else {
				/* Adresse+R senden */
				TWDR = sl_addr | 0x1;	// R				
			}
			TWCR = (1<<TWINT) | (1<<TWEN) | (1<<TWIE);
			break;
		}
		/* Datum versandt, ACK empfangen */
		case TW_MT_DATA_ACK: {
			if (txSize == 0) {
				/* ReStart senden */
				TWCR = (1<<TWINT) | (1<<TWEN) | (1<<TWIE) | (1<<TWSTA);	// ReStart senden
				break;
			}
			/* no break */
		}
		/* SLA+W, ACK empfangen */
		case TW_MT_SLA_ACK: {
			/* Daten senden */
			TWDR = *pTxData;
			pTxData++;
			txSize--;
			TWCR = (1<<TWINT) | (1<<TWEN) | (1<<TWIE);
			break;
		}
		/* SLA+R, ACK empfangen */
		case TW_MR_SLA_ACK: {
			/* Auf Daten warten */
			if (rxSize > 1) {
				TWCR = (1<<TWINT) | (1<<TWEN) | (1<<TWIE) | (1<<TWEA);	// ACK senden
			} else {
				TWCR = (1<<TWINT) | (1<<TWEN) | (1<<TWIE);	// NACK senden
			}
			break;
		}
		/* Datum empfangen, ACK gesendet */
		case TW_MR_DATA_ACK: {
			/* Daten speichern */
			*pRxData = TWDR;
			pRxData++;
			rxSize--;
			if (rxSize > 0) {
				/* es folgen noch weitere Daten, ACK senden */
				TWCR = (1<<TWINT) | (1<<TWEN) | (1<<TWIE) | (1<<TWEA);	// ACK senden
			} else {
				/* das letzte Byte ist schon unterwegs */
				TWCR = (1<<TWINT) | (1<<TWEN) | (1<<TWIE);	// NACK senden
			}
			break;
		}
		/* Datum empfangen, NACK gesendet */
		case TW_MR_DATA_NACK: {
			/* Letztes Datum speichern */
			*pRxData = TWDR;
			TWCR = (1<<TWINT) | (1<<TWEN) | (1<<TWSTO);	// Stopp-Code senden
			i2c_complete = 128;	// Lock freigeben
			break;
		}		
		/* Fehler */
		default: {
			/* Abbruch */
			i2c_error = state;
			i2c_complete = 128;	// Lock freigeben
			TWCR = (1<<TWINT);	// Int zuruecksetzen und I2C aus
		}
	}
}

/*!
 * Initialisiert das I2C-Modul
 * @param bitrate	Init-Wert fuer Bit Rate Register (TWBR) 
 * @warning Minimale bitrate = 31kbit/s, sonst muss prescaler erhöht werden!
 */
void i2c_init(uint32_t bitrate) {
	TWBR = (F_CPU / bitrate - 16 ) / 2;
	TWSR = I2C_PRESCALER;	// Prescaler s.o.
	TWCR = 0;				// I2C aus
}

/*!
 * Sendet nTx Bytes an einen I2C-Slave und liest anschliessend nRx Bytes
 * @param sla	Slave-Adresse
 * @param *pTx	Zeiger auf Puffer fuer zu sendende Daten
 * @param nTx	Anzahl der zu sendenden Bytes, [1; 255]
 * @param *pRx	Zeiger auf Puffer fuer zu lesende Daten
 * @param nRx	Anzahl der zu lesenden Bytes, [0; 255]
 */
void i2c_write_read(uint8_t sla, const uint8_t * pTx, uint8_t nTx, uint8_t * pRx, uint8_t nRx) {
	/* Inits */
	i2c_complete = 0;
	i2c_error = TW_NO_INFO;
	sl_addr = sla;
	pTxData = pTx;
	txSize = nTx;
	pRxData = pRx;
	rxSize = nRx;
	/* Start-Code senden */
	TWCR = (1<<TWINT) | (1<<TWEN) | (1<<TWIE) | (1<<TWSTA);
}

/*!
 * Sendet ein Byte an einen I2C-Slave und liest anschliessend nRx Bytes
 * @param sla		Slave-Adresse
 * @param txData	Byte, das zunaechst an den Slave gesendet wird
 * @param *pRx		Zeiger auf Puffer fuer zu lesende Daten
 * @param nRx		Anzahl der zu lesenden Bytes
 */
void i2c_read(uint8_t sla, uint8_t txData, uint8_t * pRx, uint8_t nRx) {
	static uint8_t data;
	data = txData;
	i2c_write_read(sla, &data, 1, pRx, nRx);
}

/*!
 * Wartet, bis der aktuelle I2C-Transfer beendet ist
 * @return TW_NO_INFO (0xf8) falls alles ok, sonst Fehlercode
 */
uint8_t i2c_wait(void) {
	uint8_t ticks = TIMER_GET_TICKCOUNT_8;

	/* spinning bis Lock frei */
	while (i2c_complete == 0) {
		if (timer_ms_passed(&ticks, 50)) {
			/* Timeout */
			TWCR = 0;	// I2C aus
			return TW_BUS_ERROR;
		}
	}

	TWCR = 0;	// I2C aus
	return i2c_error;
}
#endif	// I2C_AVAILABLE
