hb9xcg/energex/plc/atmel/timer-low.c

/*
 * Energex
 * 
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
 */

/*! 
 * @file 	timer-low.c
 * @brief 	Timer und Counter fuer den Mikrocontroller
 * @author 	Benjamin Benz (bbe@heise.de)
 * @date 	26.12.05
 */



#include <avr/io.h>
#include <avr/interrupt.h>
	
#include "plc.h"
#include "timer.h"
#include "os_scheduler.h"

#ifdef OS_AVAILABLE
	static uint8_t scheduler_ticks = 0;
#endif

// ---- Timer 2 ------

/*!
  Interrupt Handler fuer Timer/Counter 2(A)
 */
#ifdef __AVR_ATmega644P__
ISR(TIMER2_COMPA_vect) {
#else
ISR(SIG_OUTPUT_COMPARE2) {
#endif
	/* ----- TIMER ----- */
	uint32_t ticks = tickCount.u32;	// TickCounter [400 us] erhoehen
	ticks++;
	tickCount.u32 = ticks;	// optimiert volatile weg, weil Ints eh aus sind
	
	sei(); 	// Interrupts wieder an, z.B. UART-Kommunikation kann parallel zu RC5 und Encoderauswertung laufen   

	if (plc_enable_sampling)
	{
		plc_sample();
	}
	
	/* --- SCHEDULER --- */
	#ifdef OS_AVAILABLE
		/* Scheduling-Frequenz betraegt 500Hz */
		if ((uint8_t)((uint8_t)ticks-scheduler_ticks) >= MS_TO_TICKS(OS_TIME_SLICE)) {
			scheduler_ticks = (uint8_t)ticks;
			os_schedule(ticks);
		}
	#endif	// OS_AVAILABLE
	
	/* Achtung, hier darf (falls OS_AVAILABLE) kein Code mehr folgen, der bei jedem Aufruf 
	 * dieser ISR ausgefuehrt werden muss! Nach dem Scheduler-Aufruf kommen wir u.U. nicht 
	 * (sofort) wieder hierher zurueck, sondern es koennte auch ein Thread weiterlaufen, der
	 * vor seiner Unterbrechung nicht in hier war. Darum muessen VOR dem Scheduler-Aufruf
	 * bereits Interrupts wieder aktiviert sein. */
}

/*!
 * initilaisiert Timer 0 und startet ihn 
 */
void timer_2_init(void) {
	TCNT2  = 0x00;            // TIMER vorladen
	
	// aendert man den Prescaler muss man die Formel fuer OCR2 anpassen !!!
	// Compare Register nur 8-Bit breit --> evtl. Teiler anpassen
	#ifdef __AVR_ATmega644P__
		TCCR2A = _BV(WGM21);	// CTC Mode
		TCCR2B = _BV(CS22);		// Prescaler = CLK/64
		OCR2A = ((XTAL/64/TIMER_2_CLOCK) - 1);	// Timer2A
		TIMSK2  |= _BV(OCIE2A);	// TIMER2 Output Compare Match A Interrupt an
	#else
		// use CLK/64 prescale value, clear timer/counter on compare match   
		TCCR2 = _BV(WGM21) | _BV(CS22);
		OCR2 = ((XTAL/64/TIMER_2_CLOCK) - 1);
		TIMSK  |= _BV(OCIE2);	// enable Output Compare 0 overflow interrupt
	#endif

	sei();                       // enable interrupts
}
