hb9xcg/energex/plc/atmel/uart.h

/*
 * Energex
 * 
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
 */

/*! 
 * @file 	uart.h 
 * @brief 	Routinen zur seriellen Kommunikation
 * @author 	Benjamin Benz (bbe@heise.de)
 * @date 	26.12.2005
 */

#ifndef UART_H_
#define UART_H_


	#include <avr/io.h>
	#include "fifo.h"
	#include "global.h"

	//#define BAUDRATE	57600	/*!< Baudrate fuer UART-Kommunikation */
	#define BAUDRATE	2400	/*!< Baudrate fuer UART-Kommunikation */
	//#define BAUDRATE	115200	/*!< Baudrate fuer UART-Kommunikation */
	#if BAUDRATE == 115200
		#define UART_DOUBLESPEED	// 2X-Mode, sonst Takt zu ungenau
	#endif
	
	#ifdef UART_DOUBLESPEED
		#define UART_CALC_BAUDRATE(baudRate) ((uint32_t)(F_CPU) / ((uint32_t)(baudRate) *8) -1)
	#else
		#define UART_CALC_BAUDRATE(baudRate) ((uint32_t)(F_CPU) / ((uint32_t)(baudRate)*16) -1)
	#endif

	#ifdef __AVR_ATmega644P__
		/* Auf dem ATMega644 benutzen wir UART 0 */
		#define UBRRH	UBRR0H
		#define UBRRL	UBRR0L
		#define UCSRA	UCSR0A
		#define UCSRB	UCSR0B
		#define UCSRC	UCSR0C
		#define UDR		UDR0
		#define RXEN	RXEN0
		#define TXEN	TXEN0
		#define RXCIE	RXCIE0
		#define UDRIE	UDRIE0
		#define UDRE	UDRE0
		#define UCSZ0	UCSZ00
		#define UCSZ1	UCSZ01
		#define RXC		RXC0
		#define TXC		TXC0
		#define U2X		U2X0
	#endif	// __AVR_ATmega644P__	
		
	/*!
	 * @brief		Sende Kommando per UART im Little Endian
	 * @param cmd	Zeiger auf das Kommando
	 * @return 	Anzahl der gesendete Bytes
	 */
	//int uart_send_cmd(command_t *cmd);
	#define uart_send_cmd(cmd)  uart_write((uint8*)cmd,sizeof(command_t));
	
	/*!
	 * @brief			Sendet Daten per UART im Little Endian
	 * @param data		Datenpuffer
	 * @param length	Groesse des Datenpuffers in Bytes
	 */
	void uart_write(const uint8_t* data, uint8_t length);
	
	/*!
	 * @brief			Liest Zeichen von der UART
	 * @param data		Der Zeiger an den die gelesenen Zeichen kommen
	 * @param length	Anzahl der zu lesenden Bytes
	 * @return			Anzahl der tatsaechlich gelesenen Zeichen
	 */
	//int16 uart_read(uint8* data, int16 length);
	#define uart_read(data, length)	fifo_get_data(&infifo, data, length);
	
	/*!
	 * @brief	Initialisiert den UART und aktiviert Receiver und Transmitter sowie den Receive-Interrupt. 
	 * Die Ein- und Ausgebe-FIFO werden initialisiert. Das globale Interrupt-Enable-Flag (I-Bit in SREG) wird nicht veraendert.
	 */
	extern void uart_init(void);
	
	/*!
	 * @brief	Wartet, bis die Uebertragung fertig ist.
	 */
	static inline void uart_flush(void){
		while (UCSRB & (1 << UDRIE));
	}
	
	extern fifo_t infifo;	/*!< FIFO fuer Empfangspuffer */
	
	/*! 
 	 * @brief	Prueft, ob Daten verfuegbar 
 	 * @return	Anzahl der verfuegbaren Bytes
 	 */
	//uint8 uart_data_available(void);
	#define uart_data_available()	infifo.count

	/*!
	 * @brief		Sendet Daten per UART mit Twike Timing.
	 * @param data		Datenpuffer
	 * @param length	Groesse des Datenpuffers in Bytes
	 */
	void uart_send_twike(const uint8_t* data, uint8_t length);


#endif	// UART_H_
