hb9xcg/energex/mediator/atmel/crc8.c

/*
This code is from Colin O'Flynn - Copyright (c) 2002
only minor changes by: M.Thomas 9/2004 and M.Walser 3/2009

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
THE SOFTWARE IS PROVIDED "AS IS", WITHOUT WARRANTY OF ANY KIND, EXPRESS OR
IMPLIED, INCLUDING BUT NOT LIMITED TO THE WARRANTIES OF MERCHANTABILITY, FITNESS
FOR A PARTICULAR PURPOSE AND NONINFRINGEMENT. IN NO EVENT SHALL THE AUTHORS OR
COPYRIGHT HOLDERS BE LIABLE FOR ANY CLAIM, DAMAGES OR OTHER LIABILITY, WHETHER
IN AN ACTION OF CONTRACT, TORT OR OTHERWISE, ARISING FROM, OUT OF OR IN
CONNECTION WITH THE SOFTWARE OR THE USE OR OTHER DEALINGS IN THE SOFTWARE.
*/


#include <inttypes.h>

#define CRC8INIT        0x00
#define CRC8POLY        0x18              //0X18 = X^8+X^5+X^4+X^0

uint8_t crc8 (uint8_t data[], uint8_t nbr_of_bytes)
{
        uint8_t  byteIdx, bitIdx, crc = CRC8INIT;

        for (byteIdx = 0; byteIdx != nbr_of_bytes; byteIdx++)
        {
                uint8_t dataByte = data[byteIdx];

                for (bitIdx=0; bitIdx<8; bitIdx++)
                {
                        uint8_t feedback_bit = (crc ^ dataByte) & 0x01;

                        if ( feedback_bit == 0x01 )
                        {
                                crc ^= CRC8POLY;
                        }
                        crc = (crc >> 1) & 0x7F;
                        if ( feedback_bit == 0x01 )
                        {
                                crc |= 0x80;
                        }

                        dataByte >>= 1;
                }
        }

        return crc;
}
