hb9xcg/energex/mediator/bootloader/bootcfg.h

/*

                           e Y8b    Y8b YV4.08P888 88e
                          d8b Y8b    Y8b Y888P 888 888D
                         d888b Y8b    Y8b Y8P  888 88"
                        d8WuHan888b    Y8b Y   888 b,
                       d8888888b Y8b    Y8P    888 88b,
           8888 8888       ,e,                                  888
           8888 888820088e  " Y8b Y888P ,e e, 888,8, dP"Y ,"Y88b888
           8888 8888888 88b888 Y8b Y8P d88 88b888 " C88b "8" 888888
           8888 8888888 888888  Y8b "  888   ,888    Y88D,ee 888888
           'Y88 88P'888 888888   Y8P    "YeeP"888   d,dP "88 888888
   888 88b,                    d8  888                     888
   888 88P' e88 88e  e88 88e  d88  888 e88 88e  ,"Y88b e88 888 ,e e, 888,8,
   888 8K  d888 888bd888 8Shaoziyang88d888 888b"8" 888d888 888d88 88b888 "
   888 88b,Y888 888PY888 888P 888  888Y888 888P,ee 888Y888 888888   ,888
   888 88P' "88 88"  "88 88"  888  888 "88 88" "88 888 "88 888 "YeeP"888


  Project:       AVR Universal BootLoader
  File:          bootcfg.h
                 user's configuration.
  Version:       4.5

  Compiler:      WinAVR 20071221 + AVR Studio 4.14.589

  Author:        Shaoziyang
                 Shaoziyang@gmail.com
                 http://avrubd.googlepages.com
                 http://groups.google.com/group/avrub?hl=en

  Date:          2008.8

  See readme.htm to get more information.

*/

#ifndef _BOOTCFG_H_
#define _BOOTCFG_H_        1

//define uart buffer's length
#define BUFFERSIZE         128

//system clock(Hz)
#ifndef F_CPU
#define F_CPU              16000000UL
#endif

//baudrate
#define BAUDRATE           38400UL

//Boot section start address(byte)
//define BootStart to 0 will disable this function
#define BootStart          0UL  // 220 bytes
//#define BootStart          0xf800UL worked

//verify flash's data while write
//ChipCheck will only take effect while BootStart enable also
#define ChipCheck          1

//In SafeMode, it will not jump to user application till update successfully
#define SafeMode           0

//In SafeMode, it will set a flag in EEPROM
#define FlagAddr           E2END

//Bootloader launch  0:comport password  1:port level
#define LEVELMODE          0

#define LEVELPORT          D
#define LEVELPIN           PD7
//port level  1:High  0:Low
#define PINLEVEL           0

//max wait password time = TimeOutCnt * timeclk
//timeout count
#define TimeOutCnt         5

//basic timer interval(ms)
#define timeclk            100

//max wait data time = TimeOutCntC * timeclk
//send 'C' command count
#define TimeOutCntC        50

//password length
#define CONNECTCNT         5

//password
#if (LEVELMODE == 0)
unsigned char ConnectKey[] = {0x41, 0x56, 0x52, 0x55, 0x42};
#endif

//comport number: 0/1/2..
#define COMPORTNo          0

//enable watchdog
#define WDG_En             0

//enable RS485/RS422 mode
#define RS485              1
//RS485/RS422 send control port
#define RS485PORT          B
#define RS485TXEn          PB3

//enable LED indication
#define LED_En             1  // 62 bytes
//LED control port
#define LEDPORT            D
#define LEDPORTNo          PD7

//some old kind of AVR need special delay after comport initialization
#define InitDelay          0

//communication checksum method   0:CRC16  1:add up
#define CRCMODE            0  // 36 bytes

//Verbose mode: display more prompt message
#define VERBOSE            0

//prompt messages
#if VERBOSE
#if LEVELMODE
const char msg6[] = "bootloader mode.";
const char msg7[] = "application mode.";
#else
//waiting for password
const char msg1[] = "waiting for password.";
#endif
//timeout
const char msg2[] = "timeout.";
//waiting for data
const char msg3[] = "waiting for data.";
//update success
const char msg4[] = "update success.";
//update fail
const char msg5[] = "update fail.";
#endif

//enable decrypt buffer
#define Decrypt            0

//crypt algorithm
//PC1 Cipher Algorithm with 128 bits key
#define PC1_128            1
//PC1 Cipher Algorithm with 256 bits key
#define PC1_256            2
//AES Cipher Algorithm with 128 bits key
#define AES_128            3
//AES Cipher Algorithm with 256 bits key
#define AES_256            4

#define Algorithm          AES_128

#if Decrypt

#if (Algorithm == PC1_128) || (Algorithm == AES_128)
//Define decrypt key: 128b
unsigned char DecryptKey[16] ={
  0xd0, 0x94, 0x3f, 0x8c, 0x29, 0x76, 0x15, 0xd8,
  0x20, 0x40, 0xe3, 0x27, 0x45, 0xd8, 0x48, 0xad,
};
#elif (Algorithm == PC1_256) || (Algorithm == AES_256)
//Define decrypt key: 256b
unsigned char DecryptKey[32] ={
  0xd0, 0x94, 0x3f, 0x8c, 0x29, 0x76, 0x15, 0xd8,
  0x20, 0x40, 0xe3, 0x27, 0x45, 0xd8, 0x48, 0xad,
  0xea, 0x8b, 0x2a, 0x73, 0x16, 0xe9, 0xb0, 0x49,
  0x45, 0xb3, 0x39, 0x28, 0x0a, 0xc3, 0x28, 0x3c,
};

#endif

#endif

#endif

//End of file: bootcfg.h
