hb9xcg/energex/(commit log)

2008-02-11 Fixed s info answer.
    [command.c, supervisor.c]
2008-02-19 Added documentation.
    [Commands.xls]
2008-03-04 Converted command table to open document format.
    [Commands.xls, commands.ods]
2008-03-04 Added eagle and supervisor code
    [cell-supervisor.brd, cell-supervisor.sch, icontroller.brd, icontroller.sch]
2008-03-24 Switched to Qt Jambi 4.4 preview 1. And added a cool QtToolbar with QActions.
2008-04-07 Beautified request description and show relative time in milliseconds.
2008-04-15 Updated to revision 0.2: New: * Simplifies I2C isolation and reduced number of cross current paths. Fixed: * FDN337N pinout * Added LED pin swap workaround
    [cell-supervisor.brd, cell-supervisor.sch]
2008-04-15 *Reduced print height. *Changed LED type to Chip LED 0805. *Added pull-ups to internal I2C bus which where removed wrongly in rev.02.
    [cell-supervisor.brd, cell-supervisor.sch]
2008-04-16 Falsche Leiterbahnverbindung aufgelöst.
    [cell-supervisor.brd]
2008-04-17 Added frame unstuffing. Code cleanup.
2008-06-14 * Prepared BatInfo. * Fixed file filter. * Added find functionality.
2008-06-29 * Compile fix. * Accelerated startup of the balancer.
    [balancer.cpp]
2008-07-02 * Various balancer fixes. * Restore GUI geometric. * Added graphical configuration of the charge current. * Added ADC quantization simulation.
    [balancer.cpp, balancer.h, battery.cpp, load.cpp, main.cpp, powersupply.cpp, powersupply.h, qtwikesimulator.cpp]
2008-07-02 * Added relais command interpretation. * Added sensor mask interpretation.
2008-07-02 * Stromversorgung von OPAMP korrigiert. * Überarbeitete Masseführung. * Differenzverstärker korrigiert. * ADC Inputs mit optionalem GAIN für Strommessung verwenden. * Spannungsteiler für Strommessung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
    [icontroller.brd, icontroller.sch]
2008-07-02 * Groundplane hinzugefügt.
    [cell-supervisor.brd, cell-supervisor.sch]
2008-08-07 Initial import of Slave BMS.
2008-08-08 Completed frame (un-)stuffing.
2008-08-08 Use just one battery internally and pretend as having three of them.
2008-08-10 Added voltage and temperature sampling.
2008-08-11 Report current and capacity to the Twike computer.
2008-08-12 Added stop interrupt to power-off the Twike.
2008-08-19 Added DriveState and BInfo. Made battery accesses thread safe.
2008-09-14 * Replaced SO-8 voltage regulators by SOT-89. * Added RTC to I2C bus. * Added hardware support for RS485 instead of RS422.
    [icontroller.brd, icontroller.sch]
2008-09-14 * Added red and green LEDs. * Cleaned up ground routing around external I2C connecter.
    [icontroller.brd, icontroller.sch]
2008-09-16 * Added emergency input on the slave bus. * Added emergency output used for Notaus relais.
    [icontroller.brd, icontroller.sch]
2008-09-19 * Added error feedback to the isolated bus. * Extended ground plane.
    [cell-supervisor.brd, cell-supervisor.sch]
2008-10-04 Successor of the icontroller to control the daisy chain.
    [commands.ods, icontroller.brd, icontroller.sch]
2008-10-04 Setup initial mediator.
    [mediator.brd, mediator.sch]
2008-10-05 Initial daisy version.
    [bom.ods, daisy.brd, daisy.sch]
2008-10-15 * Isolierter One-Wire Bus hinzugefügt. * Kleinerer DC/DC Wandler für One-Wire Bus. * Stecker neu angeordnet. * Spannungsmessung vereinfacht. * Weitere Groundplanes eingeführt. * uP hängt neu auf dem 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
    [mediator.brd, mediator.sch]
2008-10-16 * Strom Messwiderstands Bohrlöcher korrigiert. * 2.5V Spannungsreferenz hinzugefügt. * Differenzverstärker niederohmiger gemacht. * Leiterbahnen im Leistungsteil optimiert.
    [mediator.brd, mediator.sch]
2008-10-17 * Zusätzliche Stützkondensatoren eingebaut. * RS485 Abschlusswiderstand hinzugefügt.
    [mediator.brd, mediator.sch]
2008-10-17 * Partlist hinzugefügt. * RTC Quarz Bauform gewechselt.
    [mediator.brd, mediator.sch]
2008-10-17 * Weitere Stützkondensatoren. * Kleinere Aufräumarbeiten.
    [mediator.brd, mediator.sch]
2008-10-24 Added Dave's review suggestions: * Additional 10uF capacitors to DC/DC converters * Additional 100nF caoacitors to OPA2735 * Additional AGND plane on top layer * Removed AGND from ISP connector * Ext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
    Other changes:
    * A 100R termination resistor has been added to the OneWire bus.
    * The differential amplifier has been replaced by a simple inverting
    amplifier with offset compensation and low pass filter.
    [mediator.brd, mediator.sch]
2008-10-28 Minor cleanups.
    [mediator.brd]
2008-11-16 * Changed IO configuration to the new mediator board rev. 0.3 * Introduced real RS485 with HW support. Interface should be Twike compatible now. * Added external reference voltage. * Adapted ADC spee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
    [adc.c, adc.h, balancer.h, battery.c, battery.h, charge.c, charge.h, command.c]
2008-11-26 * Implemented OneWire (DS2482) i2c gateway driver. * Implemented thermal sensor (DS18S20) driver. * Removed supervisor code.
2008-11-28 * Namespace cleanups. * Switch relais according to the CMD parameter. * Increased relais delay time to 500ms. * Send BInfo to the Twike boardcomputer. * Completed temperature measurement. * Corrected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
    [battery.c, battery.h, charge.c, command.c, io.h, mediator.c, ow.c, protocol.c]
2008-12-02 * Added recorded RS485 log files of driving and charge-startup phase. * Added ATMega644P datasheet.
2008-12-02 * Fixed doubled checksum if checksum has frame value 0x10. * Better log output.
    [ReceiverThread.cpp, battery.c, protocol.h, uart.cpp]
2008-12-02 * Corrected frame unstaffing.
    [protocol.c, protocol.h]
2009-01-20 Fixed a couple of Twike communication problems: * Better RS485 bus timing (required reduction of scheduler time slice from 10ms to 2ms). * Send group header instead of data header when group package 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
    [battery.c, command.c, io.h, mediator.c, os_scheduler.h, ow.c, protocol.c, sensors.c]
2009-02-20 Added charge sequence analysis.
2009-03-22 Added LTC6802-1 device.
2009-03-24 First version able to charge and drive with NiCd Akku:
    * Added CRC check to one wire temperature sensor.
    * Added extended temperature format to one wire temperature sensor.
    * Added differential current measurement.
    * Added automatic offset compensation to current measurement.
    * Added persistent storage of capacity.
    * Added lots of BINFO checks.
    * Wait for Twike board computer on start up to reduce power consumption.
    * Corrected voltage measurement.
    * Removed simulation code.
    [adc.c, adc.h, balancer.h, battery.c, battery.h, charge.c, charge.h, command.c]
2009-04-14 Added soft reboot command.
    [command.c, mediator.c]
2009-04-17 Feature: * Added boot loader support for mediator.
    Bugfix:
    * Corrected current measurement.
    * Corrected saving of the settings during exit of application.
    Cleanup:
    * Re-added rxtx binaries to simplify distribution.
2009-10-10 Added supervisor documentation.
    [bom.ods, cell-supervisor.sch]
2009-10-10 Simplified filenames.
    [supervisor.brd, supervisor.sch]
2009-10-10 Changed to 12-cell surveillance.
    [supervisor.brd, supervisor.sch]
2009-11-20 Fixed checksum bug reported by Nicolas Schroeter.
    [protocol.c]
2009-11-29 Added NTC temperature converter.
2009-12-04 Added spi module.
2009-12-14 Added o-scope functionality to log charge current.
2010-02-20 * Added automatical power off with data primarily storage. * Implemented more accurate current measurement.
2010-02-24 Reverted psychoquaker's accidentally committed r140.
    [mediator.sch]
2010-03-04 Almost complete rework of mediator: * Added isolated SPI used for supervisor daisy chain. * Simplyfied current measurement. * Removed analogue temperature sensor. * (Hopefully) fixed IGBT damage. * A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
    [mediator.brd, mediator.sch]
2010-03-04 Many minor cleanups.
    [mediator.brd, mediator.sch]
2010-03-04 * Removed old schematic graphics. * Increased value of secondary blackout capacitor.
    [mediator.brd, mediator.sch]
2010-03-12 * Added OneWire power lane. * Replaced battery with battery clip. * Minor layout improvements.
    [mediator.brd, mediator.sch]
2010-03-14 Overhauled SPI galvanic isolation.
    [mediator.brd, mediator.sch]
2010-03-21 First "routable" version of TwixBC (Twike Battery Controller) online.
    - removed AGND (only one groundplane in this layout which is connected to (Twike-) mains (negative))
    - rearranged parts
    - removed connection errors at OPAMP
    [TwixBC.sch]
2010-03-21 - added Micromatch connector for battery connections - added NMOS for turning off ADuM by LTC (until next watchdog reset) for power saving - improved layout for easy connection of more than 1 layout 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
    some work still left - I know :-)
    [LTC_Balancer.brd, LTC_Balancer.sch]
2010-05-05 LTC_Balancer:
    - board available
    - changes in battery connector and interface isolation
    [LTC_Balancer.brd, LTC_Balancer.sch, TwixBC.sch]
2010-06-05 Fixed decoding of "transmit data" packet.
    [decoder.cpp]
2010-07-09 Enlarged LTC6802 pads for easier manual soldering.
    [supervisor.brd, supervisor.sch]
2010-07-26 Initial version of power line controller.
    [powerlinecontroller.brd, powerlinecontroller.sch]
2010-07-26 Initial version of powerline controller.
    [powerlinecontroller.brd, powerlinecontroller.sch]
2010-07-26 Deleted accidentally committed file.
    [powerlinecontroller.sch]
2010-07-26 Added lock property.
    [powerlinecontroller.brd, powerlinecontroller.sch]
2010-08-21 * Reworked SPI gateway * Added dedicated controller for IGBT gate. * Allow more power on emergency switch (up to 5A). * Reduced power consumption. * Better 12V blackout handling.
    [mediator.brd, mediator.sch]
2010-08-27 * Corrected emergency stop circuit.
    [mediator.brd, mediator.sch]
2010-09-14 * Exchanged port SS with PB0.
    [mediator.brd, mediator.sch]
2010-09-14 * Switch both phase and neutral wire. * Exchanged slave select with PB0 as in mediator. * Use Mosfet instead of transistor for switching relais.
    [powerlinecontroller.brd, powerlinecontroller.sch]
2010-09-17 * Some minor text correction.
    [mediator.brd]
2010-09-17 * Corrected voltage controller. * Added ability to power up the plc from the Twike power. * Added protection resistors.
    [powerlinecontroller.brd, powerlinecontroller.sch]
2010-10-25 * Fixed firmware update when image wasn't correctly aligned to ATMega644p's page size of 256byte. * Added new feature to distinguish between Mediator and PLC firmware update.
    [downloaddialog.cpp, downloaddialog.h, downloader.cpp, downloader.h]
2010-12-23 * Adapted to Mediator hardware revision 1.0. * Added cell balancing. * Added RTC support. * Added more persistent data. * Added NTC temperature sensor linearization * Added initial version of a lithi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
2010-12-23 * Added mediator revision 0.4 and revision 1.0 fuse bits.
2010-12-23 * Initial version of power line controller.
2010-12-23 Contains several bug fixes and cleanups: * Removed sensor stack usage print out. * Fixed some thread safety issues. * Corrected temperature report to the Twike board computer. * Corrected battery ind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
    [balancer.c, balancer.h, battery.c, charge.c, command.c, error.h, ltc6802.c, ltc6802.h]
2011-01-08 * Changed Supervisor design from LTC6802-1 to LTC6802-2 for better EMI robustness.
    [supervisor.brd, supervisor.sch]
2011-01-09 * Added LTC6802-2 datasheet * Added additional mosfet to ensure proper GND on SPI isolation. * Corrected cell 12 connection. * Minor cleanups.
    [supervisor.brd, supervisor.sch]
2011-01-16 * Resolved DRC problems. * Replaced a few devices by alternatives.
    [supervisor.brd, supervisor.sch]
2011-01-18 * Added additional pullup resistor R53.
    [supervisor.brd, supervisor.sch]
2011-02-09 * Adjusted wire position at two ltc6802-2 pins. * Reduced value of R52 from 1M to 100k to be on the safe side concerning leakage current of optocoupler. * Reduced jumper text to increase isolation.
    [supervisor.brd, supervisor.sch]
2011-02-12 Moved from A4 sheet to A3.
    [supervisor.brd, supervisor.sch]
2011-02-12 * Increased GND plane isolation to 13mil (0.33mm) * Added different GND plane with 5 mil isolation on digital IO side. * Moved documentation from top copper layer to top docu layer. * Further cleanup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
    [supervisor.brd, supervisor.sch]
2011-02-13 * Minor routing cleanup around T13 und R53.
    [supervisor.brd, supervisor.sch]
2011-02-13 * Version 0.6 preparing production.
    [supervisor.brd, supervisor.sch]
2011-02-20 * Moved SMT devices on battery side to top layer. * Corrected rush-in protection z-diodes. * Increased version to revision 0.7.
    [supervisor.brd, supervisor.sch]
2011-02-20 * Moved SMT devices on digital IO side to top layer. * Increased version to revision 0.8.
    [supervisor.brd, supervisor.sch]
2011-02-20 * Fixed missing connection between R51 and C21. * Minor text placment changes for A0...A3.
    [supervisor.brd]
2011-02-21 * Increased GND plane isolation from 15 to 16mil resp. from 5 to 6mil. * Added some more vias to fill GND plane. * Added project name on silk screen. * Updated part list (2 Watt resistors and version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
    [supervisor.brd]
2011-02-23 * Move pull up resistor from GND to each data line. * Use 470 instead of 475 Ohm resistors for the LEDs.
    [supervisor.brd, supervisor.sch]
2011-02-27 * Fixed accidentally resetting of total Ah discharge counter. * Corrected saving of total Ah charge counter.
    [charge.c, charge.h, data.c, mediator.c]
2011-03-01 * Replaced 0603 package by 0402 package on the following resistors: R49, R50 (3k9) R52, R53, R54, R55, R60, R61 (100k) R57, R58, R59 (1M)
    [supervisor.brd, supervisor.sch]
2011-03-08 * Increased version number in schematics.
    [supervisor.sch]
2011-04-21 * Added BINFO command. * Stop balancer thread during flash command. * Added some command help.
2011-04-21 * Wake up supervisors before calibrating gauge. * Doubled SPI speed to 250kHz.
2011-04-21 * Adapted code to addressed behavior of LTC6802-2. * Removed unused delay between temperature and voltage measurement.
2011-04-21 * Enabled under/over voltage check and cable break check.
2011-04-22 Removed stale project: The mediator is the successor of the icontroller.
    [commands.ods, icontroller.brd, icontroller.sch]
2011-04-22 Prepared code for first test drive: * Report general error to twike board computer. * Enabled balancer during charge phase. * Removed daisy chain test code.
    [balancer.c, error.c, ltc6802.h, mediator.c]
2011-04-22 * Avoid starvation of balancer thread during long command execution.
    [uart.c, uart.h]
2011-05-12 * Fine tuning charge process allowing DX charge (90%) and normal charge (75%). * Reenabled cable check as SPI bus is working reliable now. * Enable fans during cell balancing. * For now disabled IGBT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
    [adc.h, balancer.c, balancer.h, battery.c, charge.c, gauge.c, io.c, mediator.c]
2011-05-12 * Removed dependency to ko. * Abort charge if BINFO contains bit CHARGE_NOK. * Keep power during sym charge. * Show relais status with flashing LED. * Do not restart charge if battery is full.
2011-05-12 * Fixed invalid voltage measurement after warm start.
    [mediator.c]
2011-06-13 Version used on Whit Monday: * Extended charge capacity to 4.15V per cell. * Added patch for defect ATMega port (disabled by default).
2011-09-26 Integrated Peter Celo´s modifications for revision 1.1: 1. Den IGBT habe ich durch einen IXFA16N50P Mosfet ersetzt 2. Beim MIC4420 müssen Pin 6 und Pin 7 direkt verbunden werden. 3. Zwischen ATMega P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
    [mediator.brd, mediator.sch]
2011-09-26 * Take Supervisor bus supply from VCCINT to avoid communication interrupts when emergency stop is pressed.
    [mediator.brd, mediator.sch]
2011-10-02 * Implemented new port enumerator provided by qextserialport. * Removed no longer needed threads. * Speed up firmware download.
    [downloaddialog.cpp, downloaddialog.h, downloader.cpp, downloader.h, settingsdialog.cpp, twikeport.cpp, twikeport.h]
2012-05-27 * Corrected total Ah counter.
    [charge.c]
2012-05-27 * Switch on Mosfet a bit earlier.
2012-05-27 * Changed firmware to new 3x3 motor firmware version.
2012-05-27 Removed stale project.
    [LTC_Balancer.brd, LTC_Balancer.sch, TwixBC.brd, TwixBC.sch]
2013-04-27 Initialize fifo before interrupt are running.
2013-05-06 Corrected power transistor type.
    [mediator.brd, mediator.sch]
2014-03-14 Report low cell voltage with Twike Warning LED Report unbalanced battery stack with flashing Twike Warning LED.
2014-03-14 Fixed debug interface for temperature sensors.
    [command.c]
2014-03-14 Better handling for deep discharge: - Switch off power when Twike doesn't boot up, e.g. emergency button pressed. - Adjusted low voltage levels.
    [mediator.c]
2014-03-14 Lowered cell low voltage level. It's now used as end of discharge level (3.0V).
2014-03-14 Bugfix: The total Ah counter was not incremented on short drives below 1Ah. This commit makes the necessary variables persistant in the EEPROM.
    [charge.c, charge.h, data.c]
